saksham-vlsi/Precision-analog-sensor-/docs/images/calculated_response.png

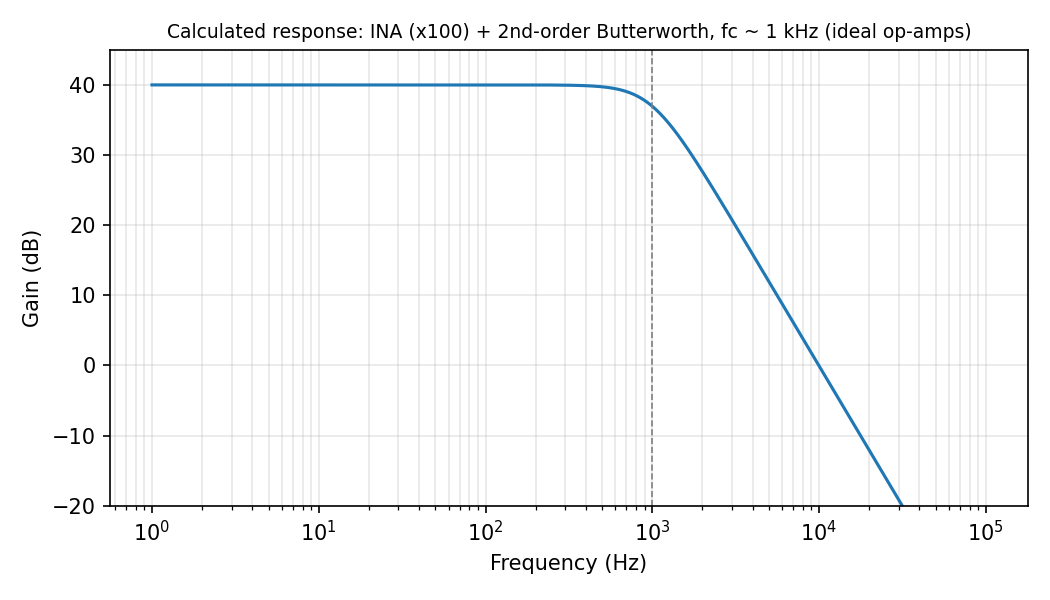
docs/images/calculated_response.png
