saksham-vlsi/Precision-analog-sensor-/simulation/ina_filter_montecarlo.cir

* ============================================================================
* MONTE-CARLO VARIANT (LTspice only - uses mc()).  Precision Analog Sensor Front-End : 3-op-amp INA (G1=20.05) + diff amp (G2=5)
*                                     + 2nd-order Sallen-Key Butterworth LPF
* Single supply 3.3 V, mid-rail reference 1.65 V.  Open in LTspice: File > Open.
* ============================================================================
.include opamp_rr.lib

.param Vdd=3.3
.param R1v=10k Rgv=1.05k R2v=20k R3v=100k
.param Rfv=11.3k C2v=10n C1v=20n
.param tolr=0.001 tolrf=0.01 tolc=0.05

* ---- supply & mid-rail reference (divider + buffer A4) ---------------------
Vdd  vdd 0 {Vdd}
Rd1  vdd vrefin 10k
Rd2  vrefin 0   10k
Cd1  vrefin 0   1u
XA4  vrefin vref vref vdd 0 OPA_RR
Cref vref 0 100n

* ---- bridge sensor model: common-mode 1.65 V, differential 'sig' -----------
* sig: AC=1 for .ac, +/-10 mV square wave for .tran, DC value for .op
Vsig  sig 0 DC 0 AC 1 PULSE(-10m 10m 2m 1u 1u 8m 20m)
Vcm   vcmn 0 {Vdd/2}
Ep    ipsrc vcmn sig 0  0.5
En    insrc vcmn sig 0 -0.5
Rsp   ipsrc inpx 500
Rsn   insrc innx 500

* ---- input protection / RFI filter -----------------------------------------
Rfp   inpx inp 1k
Rfn   innx inn 1k
Cdif  inp inn 10n
Ccp   inp 0 1n
Ccn   inn 0 1n

* ---- INA stage 1 (A1, A2) ---------------------------------------------------
XA1   inp a1n o1 vdd 0 OPA_RR
XA2   inn a2n o2 vdd 0 OPA_RR
R1a o1 a1n {mc(R1v,tolr)}
R1b o2 a2n {mc(R1v,tolr)}
Rg a1n a2n {mc(Rgv,tolr)}

* ---- INA stage 2: difference amplifier (A3), gain R3/R2, referenced to Vref -
XA3   a3p a3n o3 vdd 0 OPA_RR
R2p o1 a3p {mc(R2v,tolr)}
R3p a3p vref {mc(R3v,tolr)}
R2n o2 a3n {mc(R2v,tolr)}
R3n o3 a3n {mc(R3v,tolr)}

* ---- Sallen-Key low-pass (A5), unity gain -----------------------------------
Rs1 o3 skx {mc(Rfv,tolrf)}
Rs2 skx sky {mc(Rfv,tolrf)}
Cs1 skx o5 {mc(C1v,tolc)}
Cs2 sky 0 {mc(C2v,tolc)}
XA5   sky o5 o5 vdd 0 OPA_RR

* ---- ADC input network (STM32 PA0) ------------------------------------------
Radc  o5 adc 100
Cadc  adc 0 10n

* ---- analyses: 100 random draws, AC only ------------------------------------
.step param run 1 100 1
.ac dec 100 1 1meg
.meas AC gain_1Hz  FIND mag(V(adc)) AT 1
.meas AC f_3db     WHEN mag(V(adc))=gain_1Hz/1.41421 FALL=1
.end
