saksham-vlsi/Precision-analog-sensor-/measurements/adc_readback.csv

# ADC read-back: applied_uV = DMM-measured bridge voltage | reported_uV = firmware vin_uV column
applied_uV | reported_uV
