saksham-vlsi/Precision-analog-sensor-/measurements/gain_sweep.csv

# Gain sweep: vin_mV = differential voltage across the bridge output (DMM) | vout_V = DMM at ADC node
vin_mV | vout_V
