saksham-vlsi/Precision-analog-sensor-/measurements/noise_scope.csv

# Output noise: scope samples in volts (inputs tied to Vref through 500 ohm each) | AC-coupled | BW-limit on
volts
